UdhavMalpani/Dabba-Ud/outputs/plots/fig2_prop_and_battery_trades.png

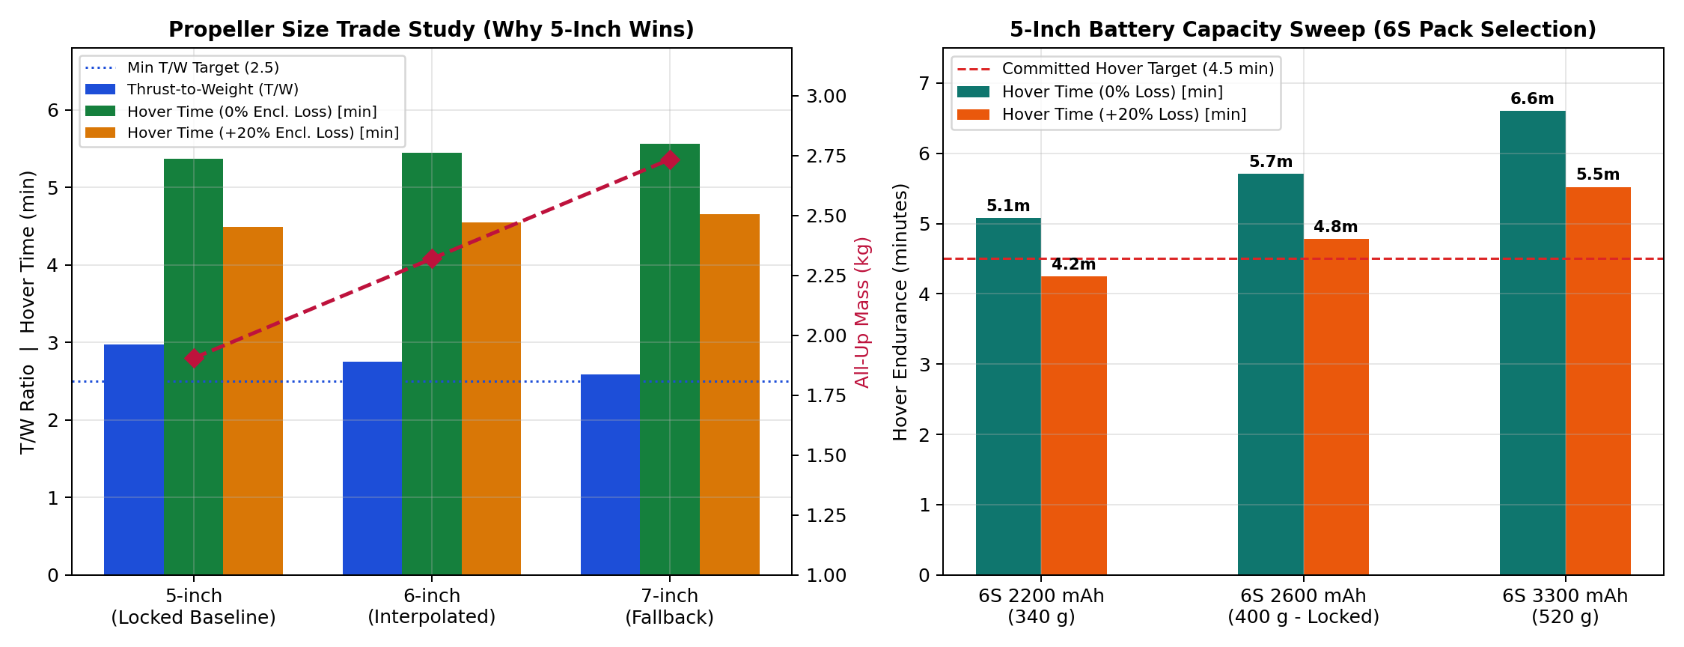
outputs/plots/fig2_prop_and_battery_trades.png
