UdhavMalpani/Dabba-Ud/outputs/plots/fig3_duct_tip_gap_and_stage0_gate.png

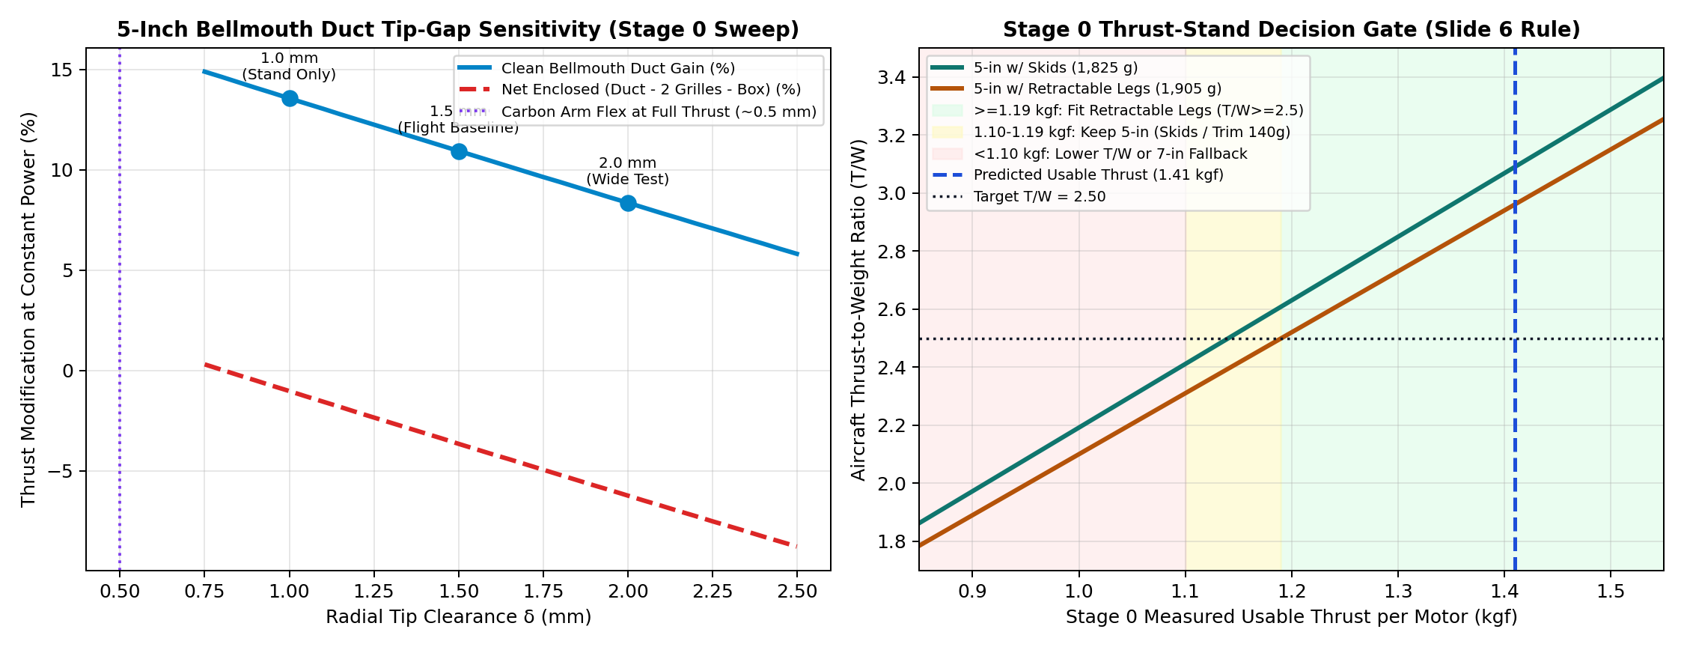
outputs/plots/fig3_duct_tip_gap_and_stage0_gate.png
