UdhavMalpani/Dabba-Ud/outputs/plots/fig4_stage1_vs_stage2_and_payload.png

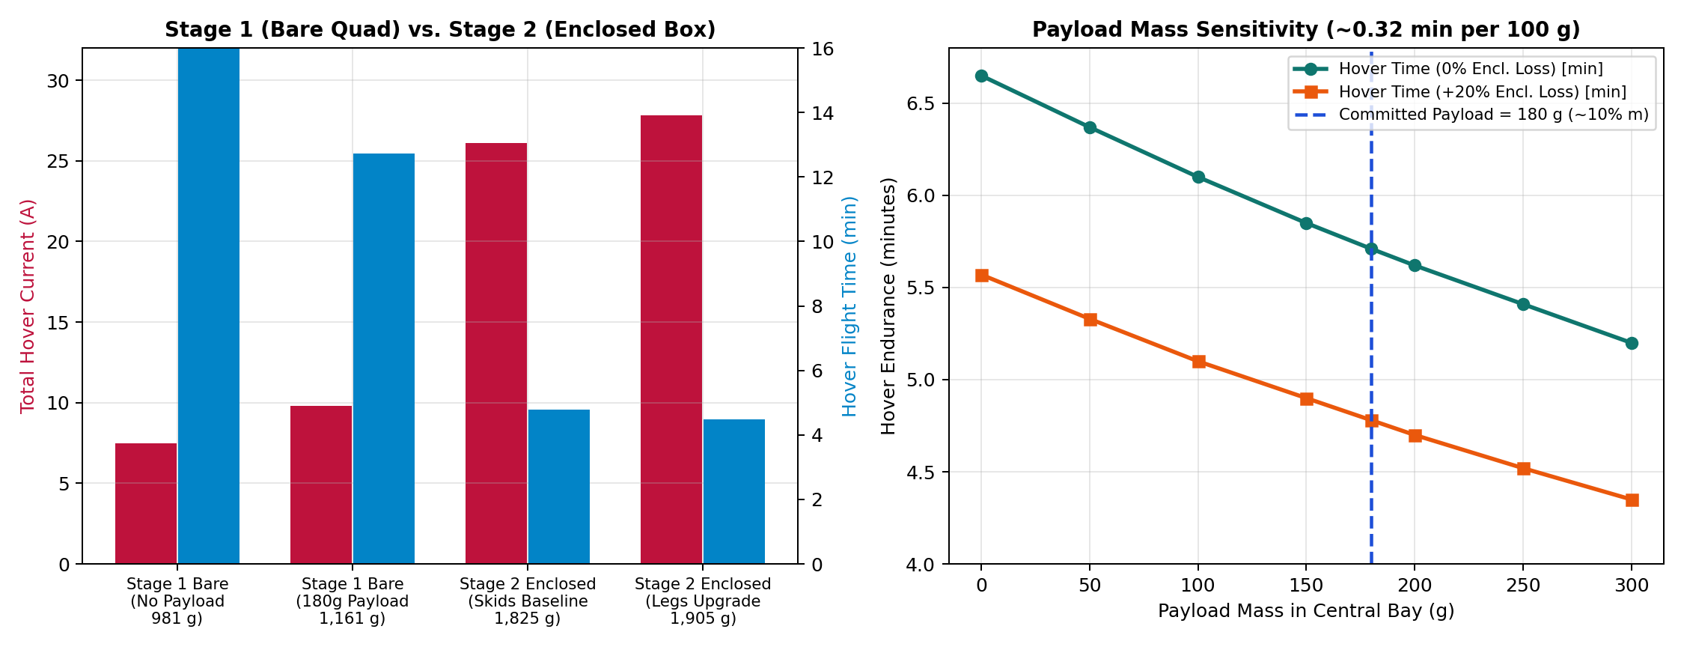
outputs/plots/fig4_stage1_vs_stage2_and_payload.png
