UdhavMalpani/Dabba-Ud/outputs/plots/fig5_crosswind_ram_drag_polar.png

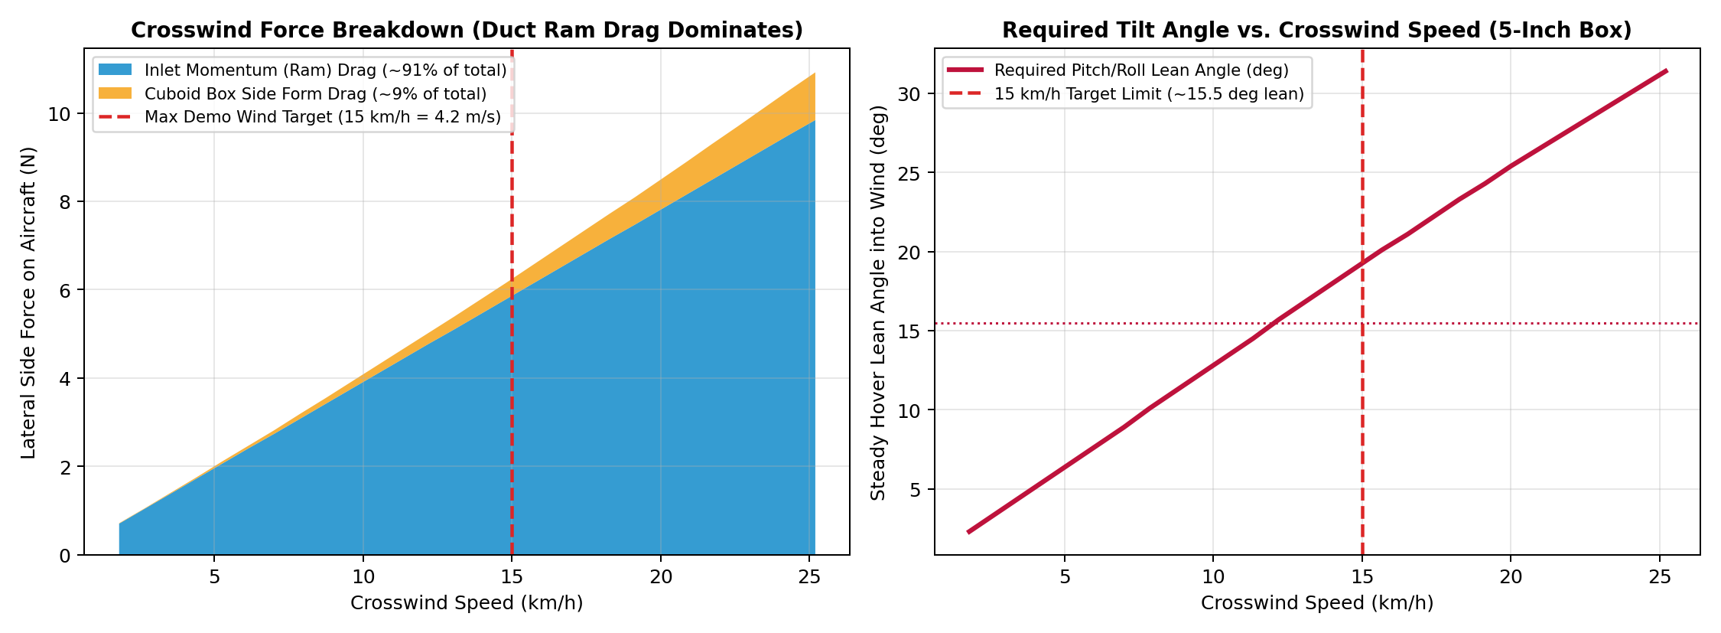
outputs/plots/fig5_crosswind_ram_drag_polar.png
