UdhavMalpani/Dabba-Ud/outputs/plots/fig6_autonomous_mission_and_failsafes.png

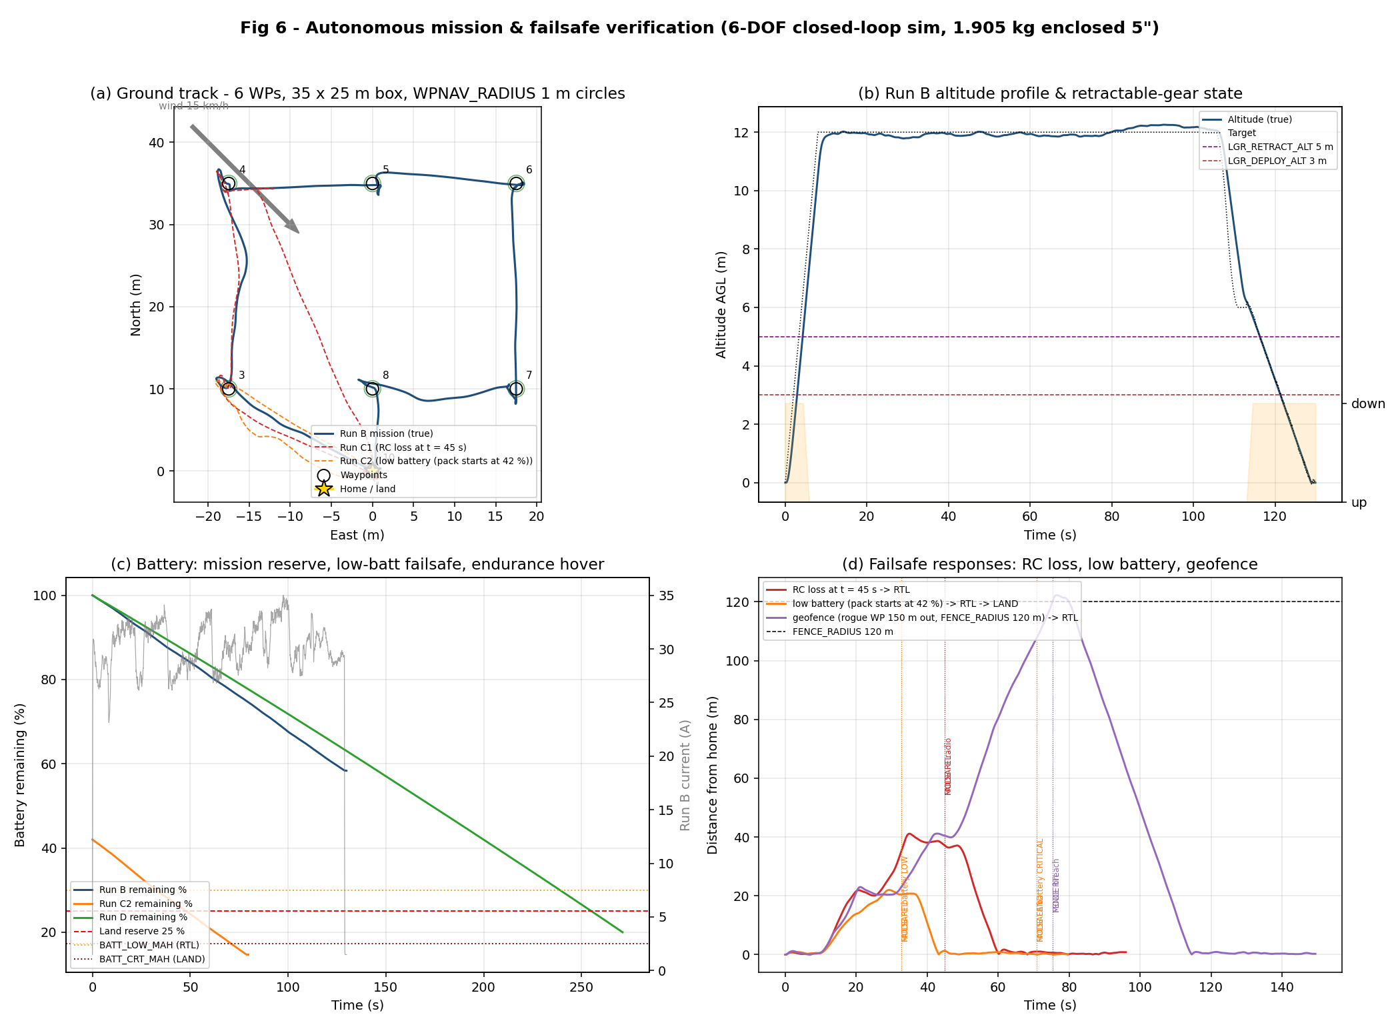
outputs/plots/fig6_autonomous_mission_and_failsafes.png
