UdhavMalpani/Dabba-Ud/outputs/plots/fig9_mass_cg_inertia_audit.png

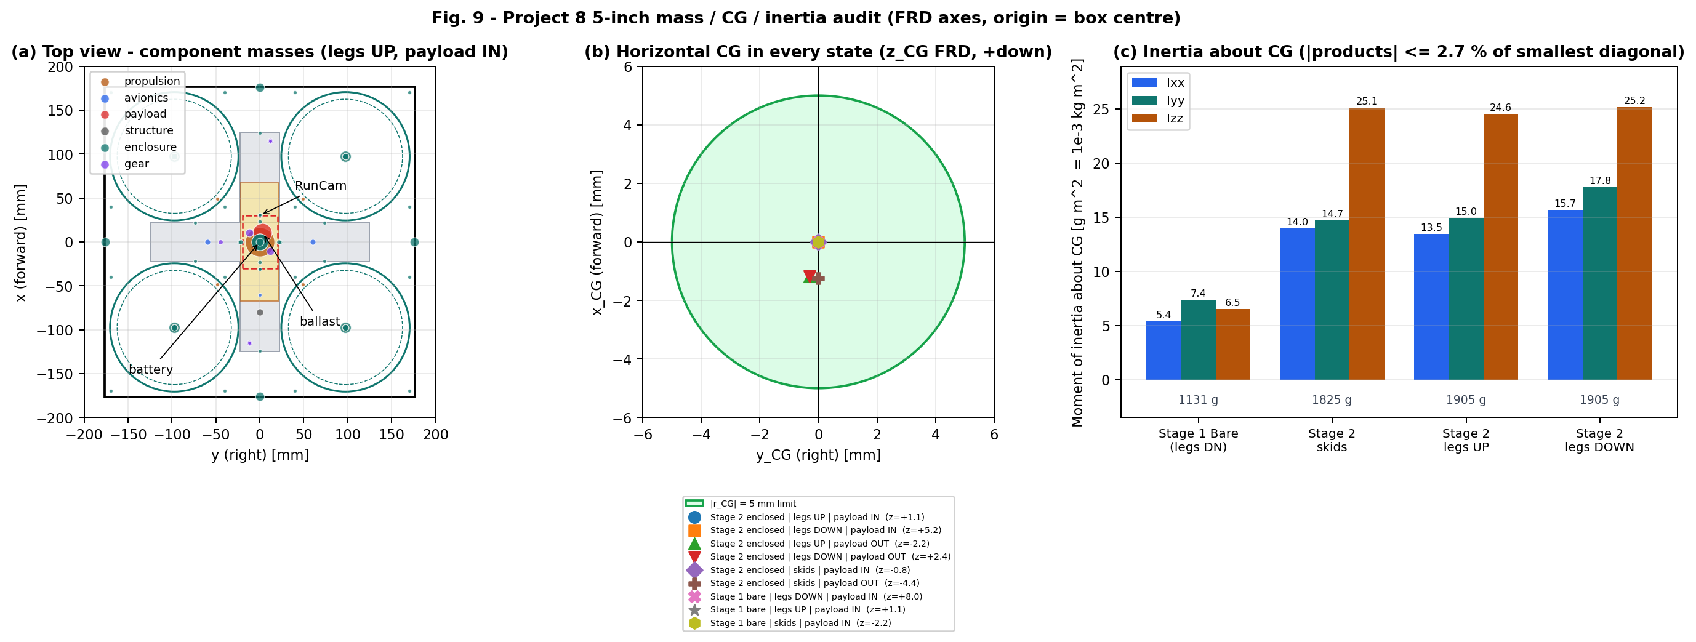
outputs/plots/fig9_mass_cg_inertia_audit.png
