UdhavMalpani/Dabba-Ud/outputs/plots/fig10_single_duct_trial.png

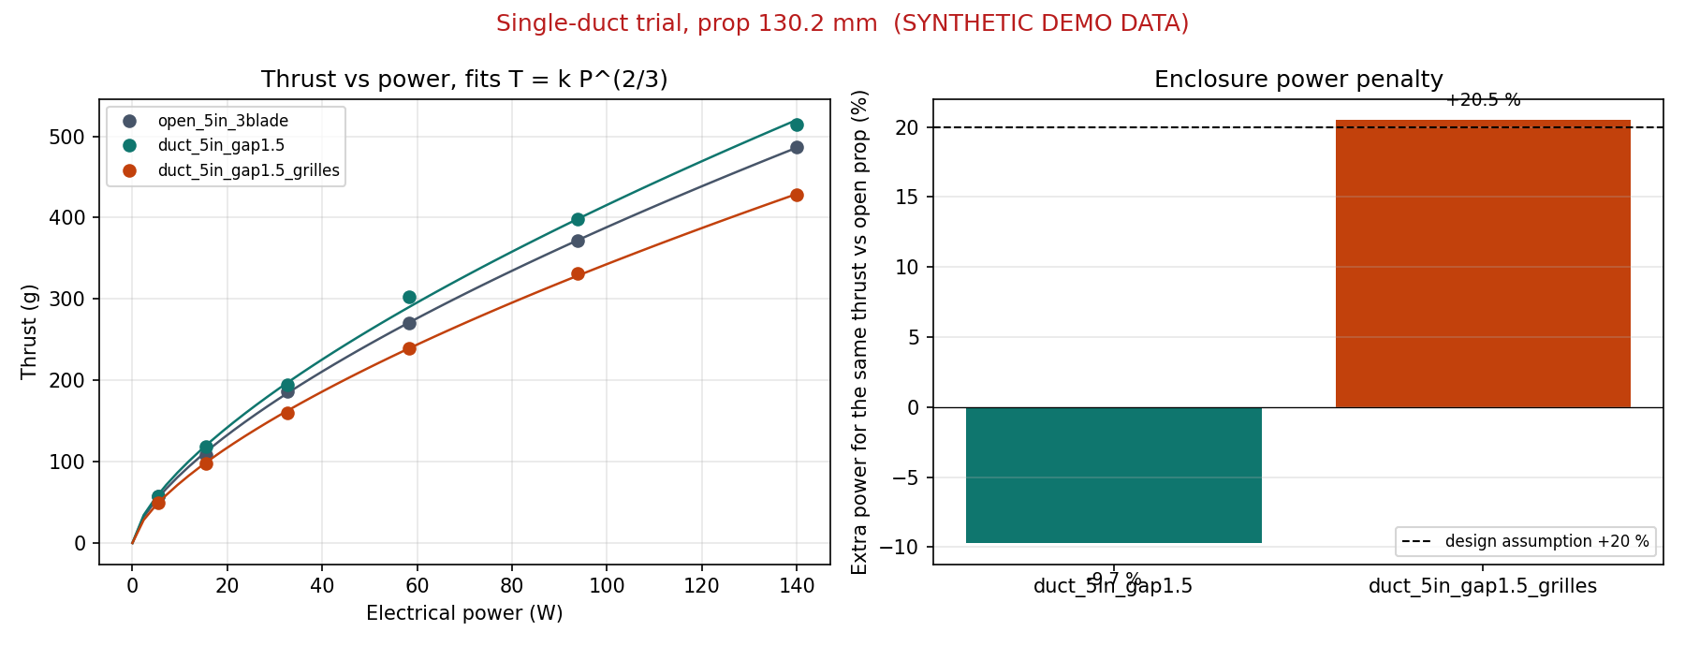
outputs/plots/fig10_single_duct_trial.png
