UdhavMalpani/Dabba-Ud/docs/procurement_robu.xlsx

Sheet: Summary
Project 8 - Robu.in procurement check (5-inch 6S build)
Checked 4 Nov 2026 against 'Project 8 - Component List BOM final.pdf'. Ship to IIIT Hyderabad, PIN 500032.
How to use
- Robu.in blocks automated page loads: stock and prices come from search snapshots, some months old. Open every link and confirm before ordering.
- Yellow cells are inputs: Qty, Unit price, Verified live?, Ordered?. Blue text = entered values. Line and sheet totals are formulas.
- Status colours: green = listing found, amber = substitute or stock uncertain, red = out of stock / not on Robu.
- Qty 0 rows are options (backup props, lab-borrowable telemetry, camera, fallback sets) - set a quantity to include them.
Changes from the submitted BOM
BOM # | BOM item | Problem on Robu | Recommendation
5, 10 | SpeedyBee F405 V4 BLS 60A stack | Out of stock (55A also) | SpeedyBee F405 V3 BLS 50A stack (ArduPilot speedybeef4v3); regenerate param files.
6 | 6S 2600 mAh >=65C XT90 | No 6S 2200-2600 >=65C pack listed | Buy 2600 65C elsewhere (keeps design), or 3 x Bonka 6S 1800 120C - see 'Battery options'.
3 | HQProp 5x4.3x3 | Not listed | Pro-Range 5045 tri-blade (5.0"), keeps 127 mm ducts.
11 | Matek M10Q-5883 | Not listed | Foxeer M10Q 250 GPS 5883.
17 | RunCam Thumb | Out of stock | RunCam Thumb Pro or any <= 30 g 1080p camera; adjust ballast.
31 | PA-CF filament | Not listed | PETG for hinges/mounts, or source elsewhere.
32 | TPU filament | Listed out of stock | Any TPU 95A brand (0.1 kg).
- | Small parts | Not in BOM | Added on 'Small parts' sheet (screws, connectors, leads, smoke stopper...).
Cost roll-up (live from each sheet)
Sheet |  |  | Total (₹)
Flight hardware
Small parts
Build materials
Test equipment
Fallback sets
Grand total (current quantities, excl. shipping)

Sheet: Battery options
6S battery options available on Robu - sizing-model results
Hover time / T/W from src/sizing/sizing_model.py (momentum theory, rho 1.09, FM 0.6, eta 0.8, 80 % usable). Max thrust scaled by (pack continuous current / 160 A)^(2/3) when the pack limits current.
Pack | Mass (g) | Capacity (mAh) | C rating | Max continuous (A) | Max thrust / motor (kgf) | AUW skids (g) | AUW legs (g) | T/W skids | T/W legs | Hover legs 0 % (min) | Hover legs +20 % (min) | Verdict | Inputs
BOM spec: 6S 2600 65C (not on Robu) | 400 | 2600 | 65 |  |  |  |  |  |  | 5.37 | 4.49 | Best - buy elsewhere if allowed. | AUW skids with 400 g pack (g) | 1825.2
Bonka 6S 1800 120C | 313 | 1800 | 120 |  |  |  |  |  |  | 3.98 | 3.33 | Recommended Robu option: full thrust, shorter endurance. | AUW legs with 400 g pack (g) | 1904.9
Pro-Range / Bonka 6S 2500 35C (~390 g est.) | 390 | 2500 | 35 |  |  |  |  |  |  | 5.20 | 4.35 | Fails T/W >= 2.5 (pack current-limited). | Full-throttle current, 4 motors (A) | 160
Orange 6S 3300 35C (~520 g est.) | 520 | 3300 | 35 |  |  |  |  |  |  | 6.22 | 5.20 | Fails T/W target; heavy. | Usable thrust per motor, unlimited (kgf) | 1.41
2 x Bonka 1800 in parallel | 626 | 3600 | 120 |  |  |  |  |  |  | 6.30 | 5.26 | Works but heavy; needs parallel harness and bay space. | Source: BOM PDF (AUW, peak current) and sizing_model.py (usable thrust).
Hover times are sizing-model outputs (hardcoded, blue); re-run src/sizing/sizing_model.py if a pack changes. T/W cells turn red below the 2.5 target.

Sheet: Flight hardware
Flight hardware
Prices/stock from search-engine snapshots of robu.in (some months old) - confirm on the live page. Yellow cells (Qty, Unit price, Verified, Ordered) are editable; line totals recalc.
BOM # | Item | Robu product / pick | Link | Status (search snapshot) | Qty | Unit price (₹) | Line total (₹) | Notes | Verified live? | Ordered?
Propulsion and power
1 | Motors | Emax ECO II 2207 1700 KV | Open (https://robu.in/product/eco-ii-series-2207-1700kv-brushless-motor/) | In stock | 5 | ₹1949 |  | 4 + 1 spare. 33.4 g without leads. Bare leads - solder straight to the 4-in-1 ESC (no bullets needed). Comes with M5 prop nut + screws. Buy ECO II, not ECO III (same price, lower thrust).
3 | Props, 5" tri-blade | Pro-Range 5045 tri-blade bullnose (5.0") | Open (https://robu.in/product/orange-hd-propellers-50455x4-5-blade-bullnose-2cw2ccw-2pairs-orange/) | Substitute | 4 | ₹200 |  | Replaces HQProp 5x4.3x3 (not on Robu). Keeps the 127 mm ducts. Caliper-measure before printing ducts. Price approx.
3b | Props, backup | Pro-Range 51433 Hurricane PC 3-blade (5.1") | Open (https://robu.in/product/orange-hd-51433-hurricane-pc-3-blade-orange/) | Listed | 0 | ₹223 |  | Only if 5045 unavailable: 5.1" needs regenerated ducts (spine clearance drops to ~1.3 mm).
4 | Props, 2-blade (stand only) | Pro-Range 5045 two-blade |  | Check stock | 2 |  |  | Optional - thrust-stand comparison only.
5+10 | FC + ESC stack | SpeedyBee F405 V3 BLS 50A 30x30 stack | Open (https://robu.in/product/speedybee-sb-f4v3-50-stack/) | Substitute | 2 | ₹6500 |  | 1 + 1 spare. Replaces F405 V4 60A (out of stock). 50 A/motor vs ~40 A peak (1.25x). ArduPilot target speedybeef4v3; param files must be regenerated. Includes 1500 uF cap. If V4 60A returns, prefer it.
5 alt | FC + ESC stack (preferred if back) | SpeedyBee F405 V4 BLS 60A stack | Open (https://robu.in/product/speedybee-f405-v4-bls-60a-30x30-fcesc-stack/) | Out of stock | 0 | ₹6979 |  | Original BOM choice.
6 | Battery 6S | Bonka 6S 1800 mAh 120C (313 g) | Open (https://robu.in/product/bonka-1800mah-120c-6s-fpv-u2-series-lithium-polymer-battery-pack/) | Check stock | 3 | ₹5989 |  | Robu has no 6S 2200-2600 >=65C pack. See 'Battery options' sheet. Check size vs 45 mm spine; likely XT60 - re-terminate to XT90 or accept XT60.
7 | Capacitor 1000 uF 50 V | Nichicon UVR1H102MHD | Open (https://robu.in/product/uvr1h102mhd-nichicon-aluminum-electrolytic-capacitor-1000uf/) | Listed | 2 | ₹44 |  | Spare - the stack ships with one.
8 | XT90 female pigtail 12 AWG | SafeConnect XT90 female pigtail | Open (https://robu.in/product/xt90-plug-female-10awg-10cm-1pcsbag/) | Listed | 2 | ₹120 |  | ESC power lead. Check gauge on the page (listing mixes 10/12 AWG).
9 | 12 AWG silicone wire | 1 m red + 1 m black | Open (https://robu.in/product/high-quality-12awg-silicone-wire-1m-red-1m-black/) | Check stock | 1 | ₹228
Avionics and radios
11 | GPS + compass | Foxeer M10Q 250 GPS 5883 | Open (https://robu.in/product/foxeer-m10q-250-gps-5883-compass/) | Substitute | 1 | ₹2729 |  | Replaces Matek M10Q-5883 (not on Robu). Same u-blox M10. Top deck, away from power leads.
13/15 | Telemetry 433 MHz (if lab has none) | Holybro SiK V3 100 mW 433 MHz | Open (https://robu.in/product/holybro-sik-telemetry-radio-v3-100-mw-433-mhz/) | Listed | 0 | ₹6499 |  | Qty 0 = borrow from lab. 433 MHz only (915 MHz not permitted in India).
16 | Buzzer | 5 V active electromagnetic buzzer (pack of 5) | Open (https://robu.in/product/5v-active-electromagnetic-buzzer-pack-of-5/) | Listed | 1 | ₹100 |  | FC BZ+/BZ- pads. Price approx.
Payload
17 | Camera | RunCam Thumb Pro | Open (https://robu.in/product/runcam-thumb-pro-nd-zz/) | Substitute | 0 | ₹10682 |  | RunCam Thumb is out of stock. Qty 0 = decide later; payload stays 180 g (adjust ballast).
Structure
19 | Carbon plate (frame) | Carbon fibre sheet 4 mm, 300 x 300 mm | Open (https://robu.in/product/carbon-fiber-sheet-300300mm-thickness-4-mm/) | In stock | 1 | ₹4693 |  | Cut the 276 mm true-X in the lab - cut wet, wear a mask (carbon dust).
Retractable legs (optional)
A1 | Leg servos | MG90S 9g metal gear, 180 deg | Open (https://robu.in/product/mg90s-9g-servo-metal-gear/) | Listed | 3 | ₹269 |  | 2 + 1 spare. NOT the 360 deg continuous version.
A2 | Servo UBEC | Bluesky mini UBEC 5 V 3 A, 2-6S | Open (https://robu.in/product/bluesky-mini-5v-3a-fpv-gimbal-ptz-ubec-for-rc-air-models/) | Listed | 1 | ₹279 |  | Alt: ReadytoSky switchable 5/12 V - set to 5 V first.
 |  |  |  |  |  | Sheet total |  | Blank unit price = not priced yet (counted as 0).

Sheet: Small parts
Small parts the BOM did not list
Prices/stock from search-engine snapshots of robu.in (some months old) - confirm on the live page. Yellow cells (Qty, Unit price, Verified, Ordered) are editable; line totals recalc.
BOM # | Item | Robu product / pick | Link | Status (search snapshot) | Qty | Unit price (₹) | Line total (₹) | Notes | Verified live? | Ordered?
+ | M3x8 socket screws | EasyMech M3x8 SHCS set (12) | Open (https://robu.in/product/easymech-set-m3-x-8mm-socket-head-cap-allen-bolt-nut-12-pcs/) | Listed | 2 | ₹60 |  | Motor to 4 mm carbon arm - max 4 mm into the motor. Price approx.
+ | M3x6 bolt set | EasyMech M3x6 bolt+nut set (25) | Open (https://robu.in/product/easymech-m3-x-6mm-chhd-bolt-nut-and-washer-set-25-pcs/) | Listed | 1 | ₹60 |  | Price approx.
+ | M3x20 socket screws | EasyMech M3x20 SHCS set (12) | Open (https://robu.in/product/easymech-set-of-m3-x-20mm-socket-head-cap-allen-bolt-and-nut-12-pcs/) | Listed | 1 | ₹80 |  | Price approx.
+ | M3x30 socket screws | EasyMech M3x30 SHCS set (12) | Open (https://robu.in/product/easymech-set-m3-x-30mm-socket-head-cap-allen-bolt-nut-12-pcs/) | Listed | 1 | ₹90 |  | Stack standoffs. Price approx.
+ | M3 nyloc nuts | EasyMech M3 nyloc (25) | Open (https://robu.in/product/easymech-set-m3-ms-nyloc-nut-25pcs/) | Check stock | 1 | ₹78 |  | Frame bolts.
33 | M3 heat-set inserts | M3 x 4 mm brass inserts (25) | Open (https://robu.in/product/m3-x-4-mm-brass-heat-set-knurl-threaded-round-insert-nut-25-pcs/) | Listed | 2 | ₹91 |  | Quarter joints, deck bosses.
+ | XT90 male | Amass XT90 male with housing | Open (https://robu.in/product/xt90-housing-male-1-piece/) | Listed | 3 | ₹71 |  | Spare battery leads / re-termination.
+ | XT90 female | Amass XT90 female with housing | Open (https://robu.in/product/xt90-housing-female-1-piece/) | Listed | 3 | ₹71 |  | Price approx.
+ | XT60 pair | Amass XT60 gold pair | Open (https://robu.in/product/amass-xt60-gold-plated-bullet-battery-connector-pair-xt60-fgy-and-xt60-mgy/) | Listed | 3 | ₹60 |  | Charger, watt meter, thrust stand. Price approx.
+ | 3.5 mm bullet male | Amass GC3510-M | Open (https://robu.in/product/amass-3-5mm-bullet-male-connector-gc3510-m/) | Listed | 6 | ₹20 |  | Thrust stand only (aircraft motors solder direct). Price approx.
+ | 3.5 mm bullet female | Amass GC3510-F | Open (https://robu.in/product/amass-3-5mm-bullet-female-connector-gc3510-f/) | Listed | 6 | ₹20 |  | Price approx.
+ | 18 AWG silicone wire | 18 AWG, 3 colours x 1 m |  | Check stock | 3 |  |  | Motor lead extensions if leads don't reach the stack (~138 mm).
A5 | Servo extension leads 30 cm | Servo extension cable 30 cm |  | Check stock | 3 |  |  | Leg servos to FC.
36 | Battery strap | Non-slip strap 20 x 300 mm | Open (https://robu.in/product/30cm-lipo-battery-strap-belt-reusable-cable-tie-wrap/) | Listed | 2 | ₹61
37 | Heat-shrink assortment | Heat-shrink kit |  | Check stock | 1 |  |  | Every solder joint.
37 | Zip ties, Velcro, 3M foam tape | - |  | Check stock | 1 |  |  | Wiring, receiver mounting.
37 | Threadlocker (medium) | Loctite 243 or equivalent |  | Check stock | 1 |  |  | Motor/frame bolts into metal only, not plastic.
+ | Spare M5 prop nuts | M5 nylock prop nuts CW + CCW |  | Check stock | 8 |  |  | 4 + 4.
+ | Solder + flux | 60/40 solder wire + flux paste |  | Check stock | 1 |  |  | XT90 / 12 AWG joints need >= 60 W iron and flux.
+ | Smoke stopper / 5 A fuse | Smoke stopper (XT60) |  | Check stock | 1 |  |  | First power-up of every build.
+ | Kapton tape | Kapton tape roll |  | Check stock | 1 |  |  | Insulation under the stack.
 |  |  |  |  |  | Sheet total |  | Blank unit price = not priced yet (counted as 0).

Sheet: Build materials
Build materials and consumables
Prices/stock from search-engine snapshots of robu.in (some months old) - confirm on the live page. Yellow cells (Qty, Unit price, Verified, Ordered) are editable; line totals recalc.
BOM # | Item | Robu product / pick | Link | Status (search snapshot) | Qty | Unit price (₹) | Line total (₹) | Notes | Verified live? | Ordered?
29 | PLA filament | Bambu Lab PLA Basic 1 kg | Open (https://robu.in/product/bambu-lab-pla-basic-1-75mm-3d-printing-filament-4/) | In stock | 2 | ₹1149 |  | Enclosure, panels, grilles, spine, door.
30 | PETG filament | Bambu Lab PETG HF 1 kg | Open (https://robu.in/product/bambu-lab-petg-hf-1-75mm-filament-peanut-brown-2/) | Listed | 1 | ₹1299 |  | Duct rings.
31 | PA-CF filament | Not on Robu |  | Not on Robu | 0 |  |  | Print hinges/mounts in PETG for now, or source elsewhere.
32 | TPU 95A filament | Pro-Range TPU 95A 1 kg | Open (https://robu.in/product/pro-range-tpu-95a-filament-1-75mm-1-kg-spool-gray/) | Out of stock | 1 | ₹1029 |  | Only 0.1 kg needed - any TPU 95A brand.
 |  |  |  |  |  | Sheet total |  | Blank unit price = not priced yet (counted as 0).

Sheet: Test equipment
Support and test equipment
Prices/stock from search-engine snapshots of robu.in (some months old) - confirm on the live page. Yellow cells (Qty, Unit price, Verified, Ordered) are editable; line totals recalc.
BOM # | Item | Robu product / pick | Link | Status (search snapshot) | Qty | Unit price (₹) | Line total (₹) | Notes | Verified live? | Ordered?
38 | Load cell + HX711 | 5 kg load cell + HX711 kit | Open (https://robu.in/product/5-kg-load-cell-with-hx711ad-module-shell-and-4p-dupont-wire-kit/) | Listed | 1 | ₹449 |  | Works with firmware/thrust_stand_logger.
38 | Watt meter | 150 A watt meter / power analyser | Open (https://robu.in/product/150a-high-precision-watt-meter-power-analyzer/) | Listed | 1 | ₹689 |  | Bare leads - solder XT60s on.
39 | 6S charger | SkyRC B6ACneo (AC built in) | Open (https://robu.in/product/skyrc-b6ac-neo-dc-200w-ac-60w-battery-charger/) | Listed | 1 | ₹5769 |  | Alt: ToolkitRC M7 (Rs 4,999) is DC-only and needs a power adapter.
40 | LiPo bag | Fireproof bag 230 x 300 mm | Open (https://robu.in/product/red-lithium-battery-protection-bag/) | Listed | 1 | ₹300 |  | Price approx.
41 | Cell checker | 1-8S checker with buzzer | Open (https://robu.in/product/lipo-battery-voltage-checker-1s-8s-with-buzzer/) | Listed | 1 | ₹191
42 | Prop balancer | Magnetic prop balancer |  | Check stock | 1 |  |  | Check listing.
 |  |  |  |  |  | Sheet total |  | Blank unit price = not priced yet (counted as 0).

Sheet: Fallback sets
Fallback sets - order only if needed
Prices/stock from search-engine snapshots of robu.in (some months old) - confirm on the live page. Yellow cells (Qty, Unit price, Verified, Ordered) are editable; line totals recalc.
BOM # | Item | Robu product / pick | Link | Status (search snapshot) | Qty | Unit price (₹) | Line total (₹) | Notes | Verified live? | Ordered?
7-inch fallback (only if Gate 1 thrust is below target)
F1 | Motors | Emax ECO II 2807 1300 KV | Open (https://robu.in/product/emax-ecoii-2807-1300kv-brushless-motor/) | In stock | 0 | ₹2259 |  | Robu spec table looks copy-pasted (1380 g, 9x6 props) - check Emax datasheet.
F2 | Props 7" tri-blade | Pro-Range 7040 Flash PC 3-blade | Open (https://robu.in/product/orange-hd-7040-flash-pc-3-blade-propellers-2cw2ccw-black/) | Substitute | 0 |  |  | Gemfan 7040-3 not on Robu. 178.4 mm disc.
F3 | Battery 6S 3300 | Orange 6S 3300 mAh 35C | Open (https://robu.in/product/orange-3300mah-6s-35c-22-2-v-lithium-polymer-battery-pack-li-po/) | Substitute | 0 |  |  | No >=60C pack on Robu. 116 A continuous - set MOT_BAT_CURR_MAX ~110 A.
4S alternative (only if 6S packs unavailable)
4S | Motors | Emax ECO II 2207 2400 KV | Open (https://robu.in/product/emax-ecoii-2207-2400kv-brushless-motor/) | In stock | 0 | ₹1611 |  | 3-4S.
4S | Battery 4S 4000 >=60C | Not on Robu |  | Not on Robu | 0 |  |  | Source elsewhere.
 |  |  |  |  |  | Sheet total |  | Blank unit price = not priced yet (counted as 0).
