UdhavMalpani/Dabba-Ud/outputs/plots/fig1_sizing_convergence_and_bom.png

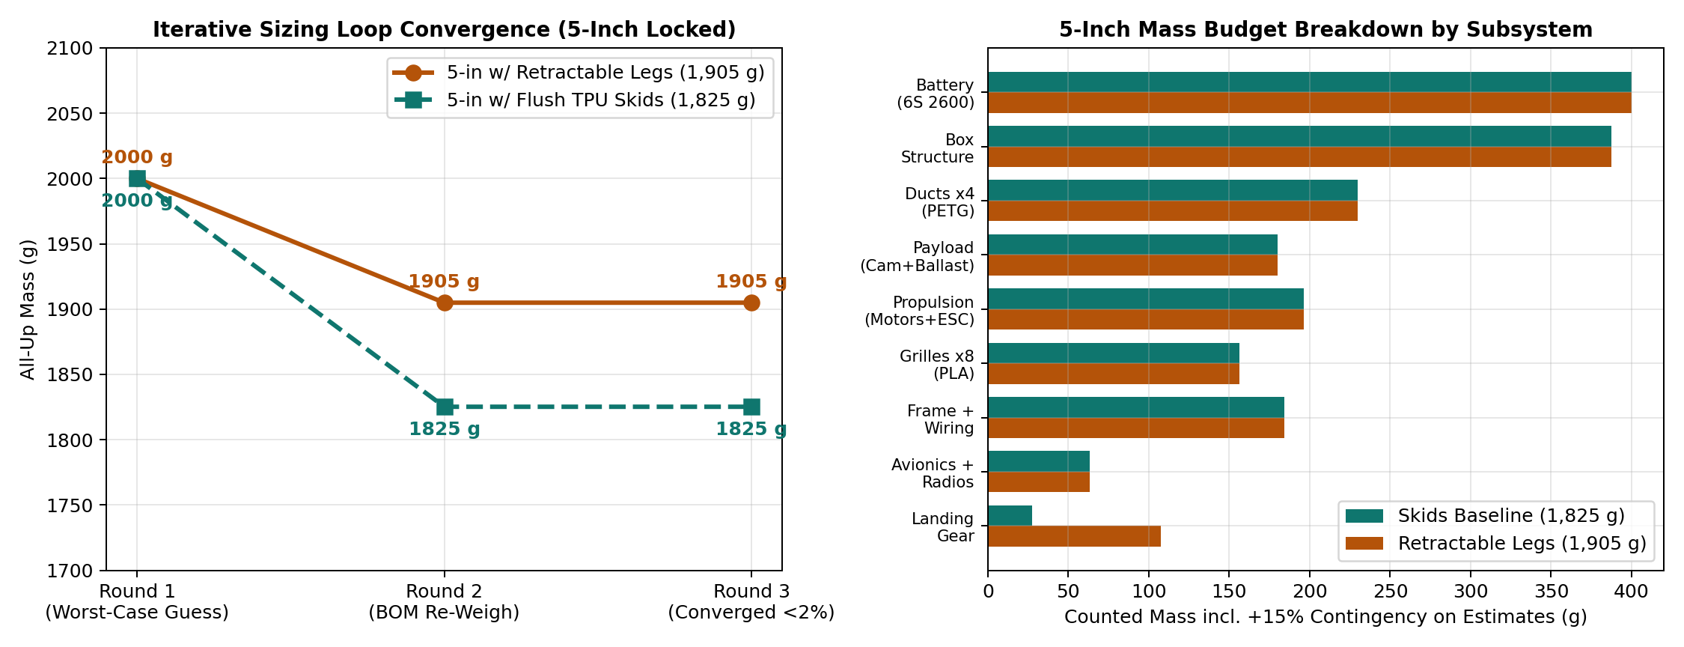
outputs/plots/fig1_sizing_convergence_and_bom.png
