UdhavMalpani/Dabba-Ud/outputs/stl/enclosure_quarter_5in_177mm.stl

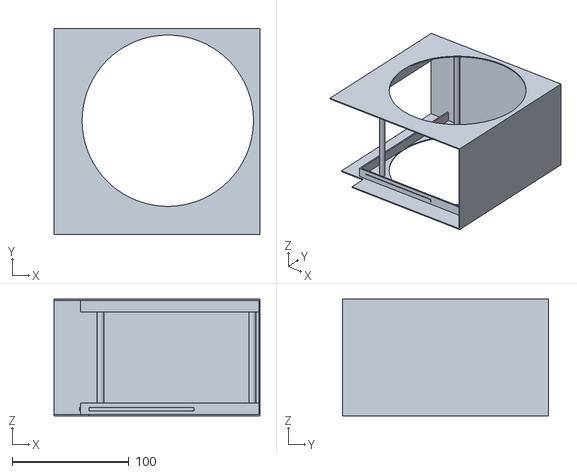
[picture p9: CAD file, 2026-10-30]
outputs/stl/enclosure_quarter_5in_177mm.stl
176.5 x 176.5 x 100.0
