UdhavMalpani/Dabba-Ud/outputs/test_rig/gcode/motor_arm_PLA.gcode.3mf

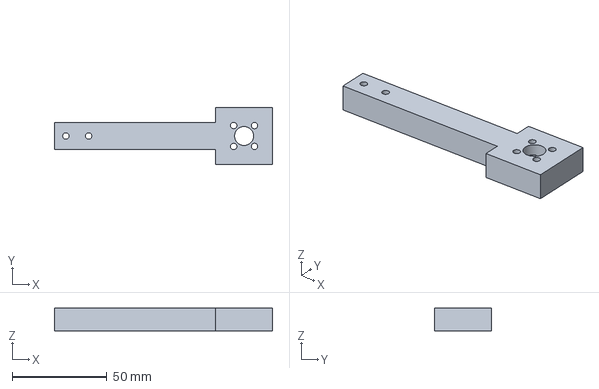
[picture p10: CAD file, 2026-11-03]
outputs/test_rig/gcode/motor_arm_PLA.gcode.3mf
115.0 x 30.0 x 12.0 mm
