UdhavMalpani/Dabba-Ud/outputs/stl/duct_ring_5in_gap1.5mm.stl

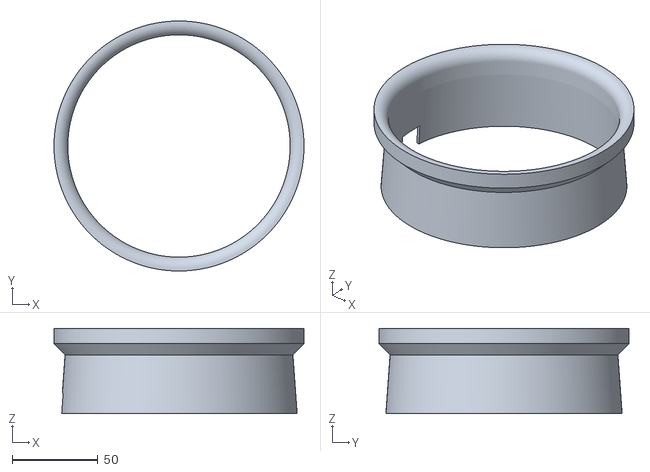
[picture p11: CAD file, 2026-10-30]
outputs/stl/duct_ring_5in_gap1.5mm.stl
146.2 x 146.2 x 50.0
