UdhavMalpani/Dabba-Ud/outputs/test_rig/stand.stl

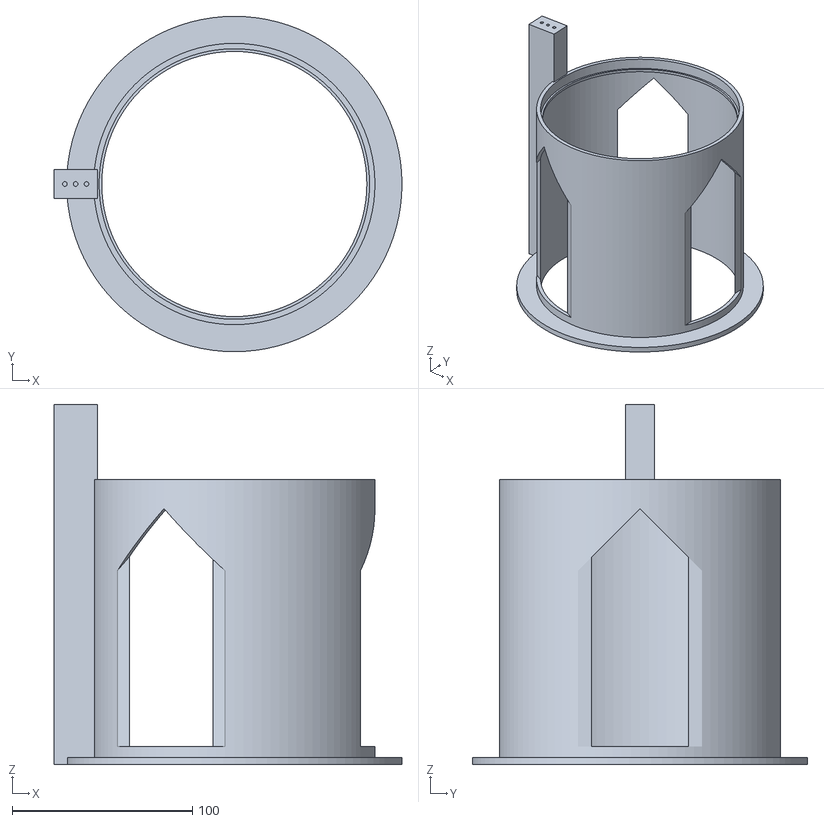
[picture p12: CAD file, 2026-11-03]
outputs/test_rig/stand.stl
193.0 x 186.0 x 199.8
