UdhavMalpani/Dabba-Ud/outputs/stl/retractable_leg_240mm.stl

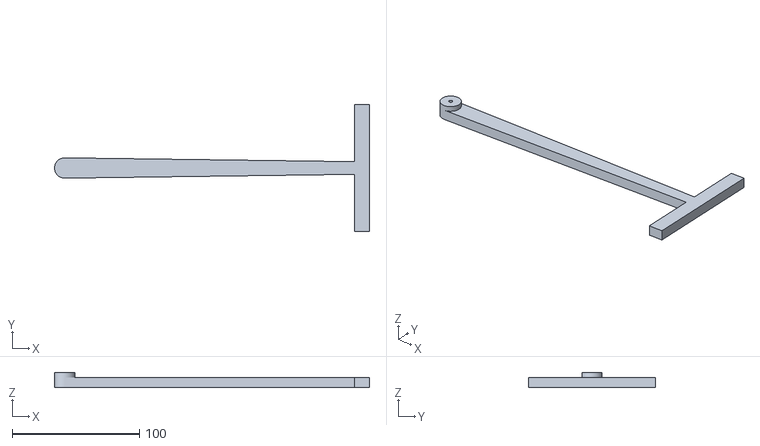
[picture p13: CAD file, 2026-10-30]
outputs/stl/retractable_leg_240mm.stl
248.0 x 100.0 x 12.0
