UdhavMalpani/Dabba-Ud/outputs/test_rig/gcode/duct_test_rig.gcode.3mf

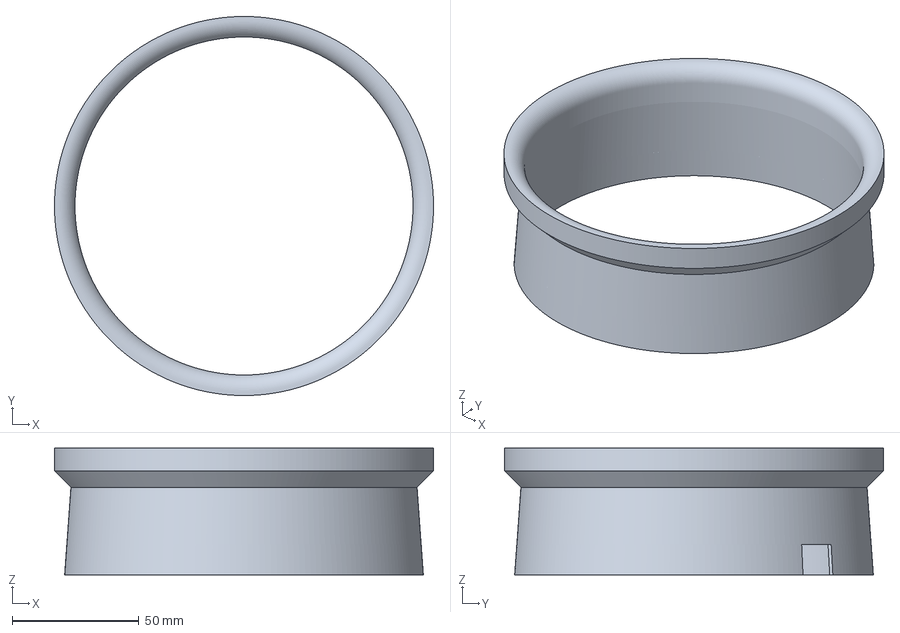
[picture p14: CAD file, 2026-11-03]
outputs/test_rig/gcode/duct_test_rig.gcode.3mf
149.4 x 149.4 x 50.0 mm
