UdhavMalpani/Dabba-Ud/outputs/test_rig/open_riser.stl

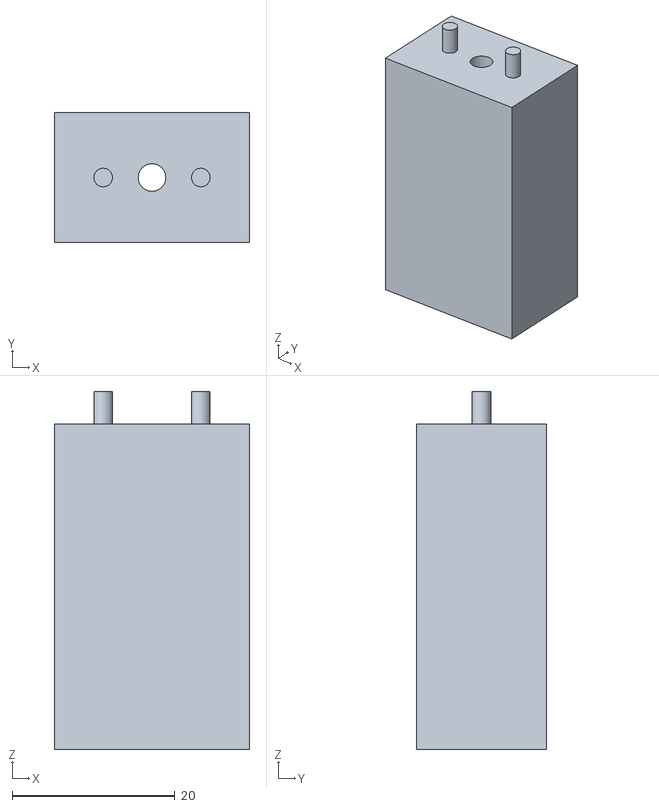
[picture p15: CAD file, 2026-11-03]
outputs/test_rig/open_riser.stl
24.0 x 16.0 x 44.0
