UdhavMalpani/Dabba-Ud/outputs/stl/grille_5in_146mm_4mm.stl

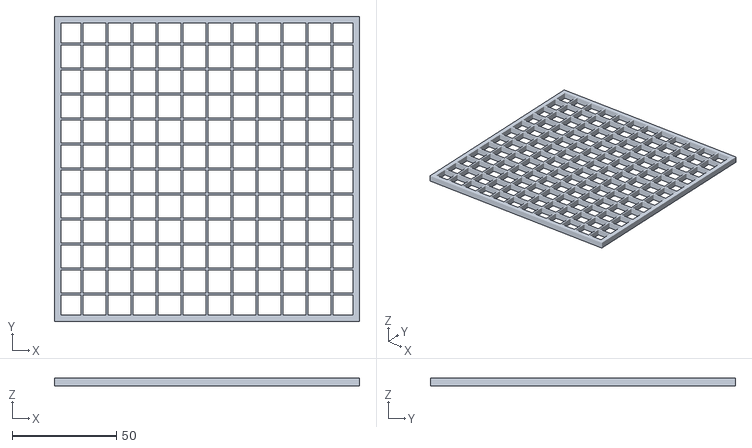
[picture p16: CAD file, 2026-10-30]
outputs/stl/grille_5in_146mm_4mm.stl
146.2 x 146.2 x 4.00
