UdhavMalpani/Dabba-Ud/outputs/test_rig/inlet_grille.stl

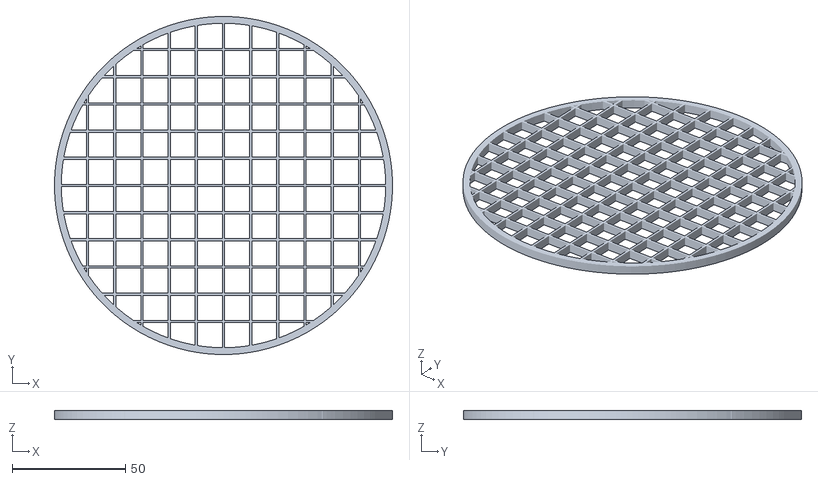
[picture p17: CAD file, 2026-11-03]
outputs/test_rig/inlet_grille.stl
149.2 x 149.2 x 4.00
