UdhavMalpani/Dabba-Ud/outputs/stl/duct_ring_5in_gap1.0mm.stl

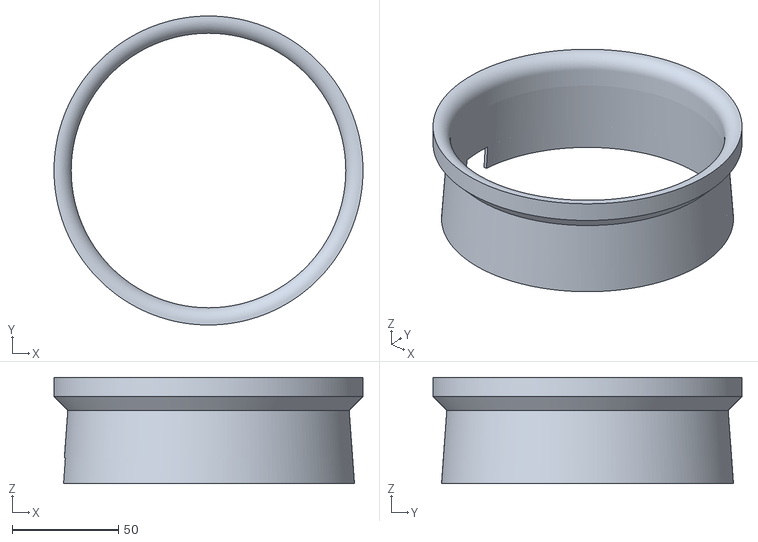
[picture p18: CAD file, 2026-10-30]
outputs/stl/duct_ring_5in_gap1.0mm.stl
145.2 x 145.2 x 50.0
