UdhavMalpani/Dabba-Ud/outputs/test_rig/fit_band.stl

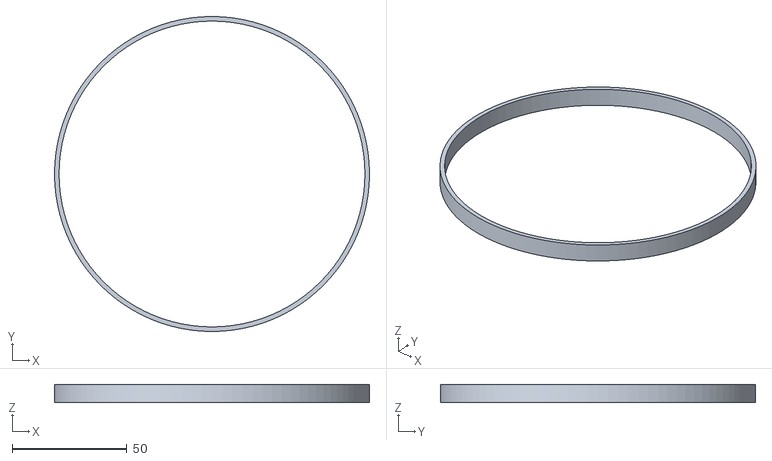
[picture p19: CAD file, 2026-11-03]
outputs/test_rig/fit_band.stl
137.2 x 137.2 x 8.00
