UdhavMalpani/Dabba-Ud/outputs/stl/cross_spine_45mm_payload_bay.stl

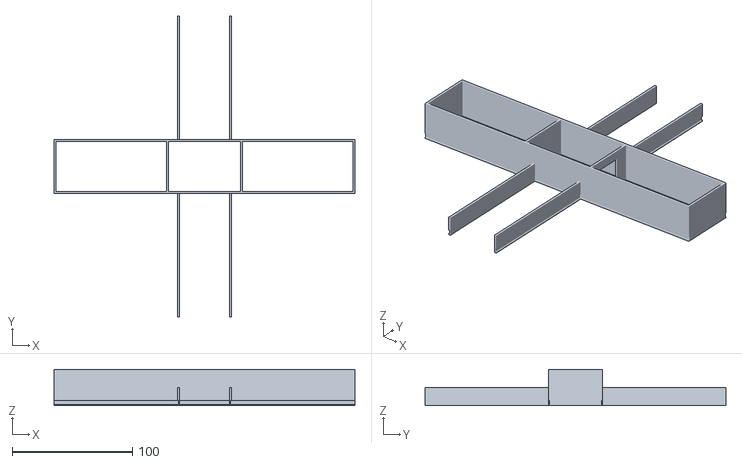
[picture p20: CAD file, 2026-10-30]
outputs/stl/cross_spine_45mm_payload_bay.stl
250.0 x 250.0 x 30.0
