UdhavMalpani/Dabba-Ud/outputs/test_rig/test_rig_dims.scad

// generated by src/cad/generate_test_rig.py from config/test_rig_measurements.json - do not edit
prop_d = 130.200;
tip_gap = 1.500;
motor_bolt_min = 11.000;
motor_bolt_max = 11.000;
motor_seat_h = 34.000;
prop_hub_t = 7.500;
motor_bell_d = 27.500;
motor_center_d = 10.000;
inlet_clear = 150.000;
