UdhavMalpani/Dabba-Ud/(list of files, cad)

Other CAD files:
outputs/test_rig/motor_arm.stl
outputs/test_rig/gcode/motor_arm.gcode.3mf
outputs/test_rig/gcode/open_riser.gcode.3mf
outputs/test_rig/gcode/stand.gcode.3mf
outputs/stl/duct_ring_5in_gap2.0mm.stl
outputs/test_rig/gcode/fit_band_PLA.gcode.3mf
outputs/test_rig/grille_test_rig.stl
outputs/test_rig/duct_test_rig.stl
outputs/test_rig/gcode/duct_test_rig_PLA.gcode.3mf
outputs/test_rig/gcode/inlet_grille.gcode.3mf
outputs/test_rig/gcode/grille_test_rig.gcode.3mf
outputs/test_rig/gcode/fit_band.gcode.3mf
