UdhavMalpani/Dabba-Ud/outputs/test_rig/assembly_cutaway.png

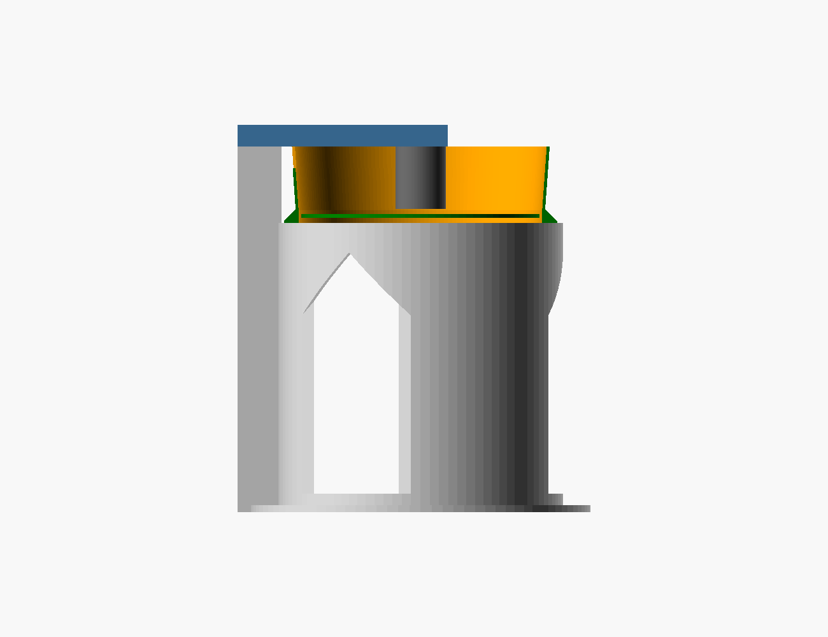
outputs/test_rig/assembly_cutaway.png
