UdhavMalpani/Dabba-Ud/outputs/test_rig/assembly_preview.png

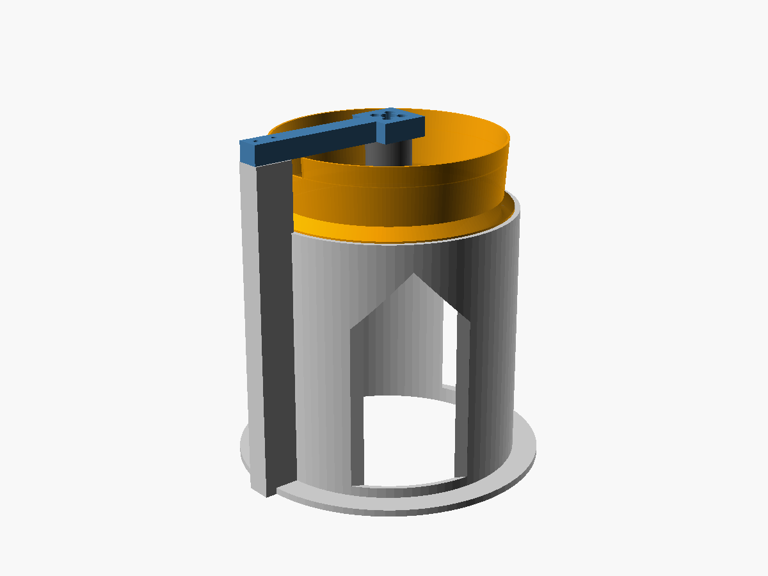
outputs/test_rig/assembly_preview.png
