UdhavMalpani/Dabba-Ud/outputs/test_rig/single_duct_trial_DEMO_synthetic.csv

# SYNTHETIC demo data - generated by --demo | not a measurement
config | tip_gap_mm | pwm_us | throttle_pct | thrust_g | voltage_v | current_a | power_w | rpm
open_5in_3blade |  | 1200 | 20 | 57 | 15.59 | 0.35 | 5.4 | 0
open_5in_3blade |  | 1300 | 30 | 108 | 15.58 | 0.99 | 15.5 | 0
open_5in_3blade |  | 1400 | 40 | 186 | 15.56 | 2.10 | 32.7 | 0
open_5in_3blade |  | 1500 | 50 | 270 | 15.53 | 3.76 | 58.4 | 0
open_5in_3blade |  | 1600 | 60 | 372 | 15.48 | 6.06 | 93.8 | 0
open_5in_3blade |  | 1700 | 70 | 487 | 15.42 | 9.08 | 140.0 | 0
duct_5in_gap1.5 | 1.5 | 1200 | 20 | 57 | 15.59 | 0.35 | 5.4 | 0
duct_5in_gap1.5 | 1.5 | 1300 | 30 | 119 | 15.58 | 0.99 | 15.5 | 0
duct_5in_gap1.5 | 1.5 | 1400 | 40 | 194 | 15.56 | 2.10 | 32.7 | 0
duct_5in_gap1.5 | 1.5 | 1500 | 50 | 303 | 15.53 | 3.76 | 58.4 | 0
duct_5in_gap1.5 | 1.5 | 1600 | 60 | 398 | 15.48 | 6.06 | 93.8 | 0
duct_5in_gap1.5 | 1.5 | 1700 | 70 | 515 | 15.42 | 9.08 | 140.0 | 0
duct_5in_gap1.5_grilles | 1.5 | 1200 | 20 | 49 | 15.59 | 0.35 | 5.4 | 0
duct_5in_gap1.5_grilles | 1.5 | 1300 | 30 | 98 | 15.58 | 0.99 | 15.5 | 0
duct_5in_gap1.5_grilles | 1.5 | 1400 | 40 | 160 | 15.56 | 2.10 | 32.7 | 0
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
