UdhavMalpani/Dabba-Ud/outputs/plots/fig7_stage0_thrust_stand_results.png

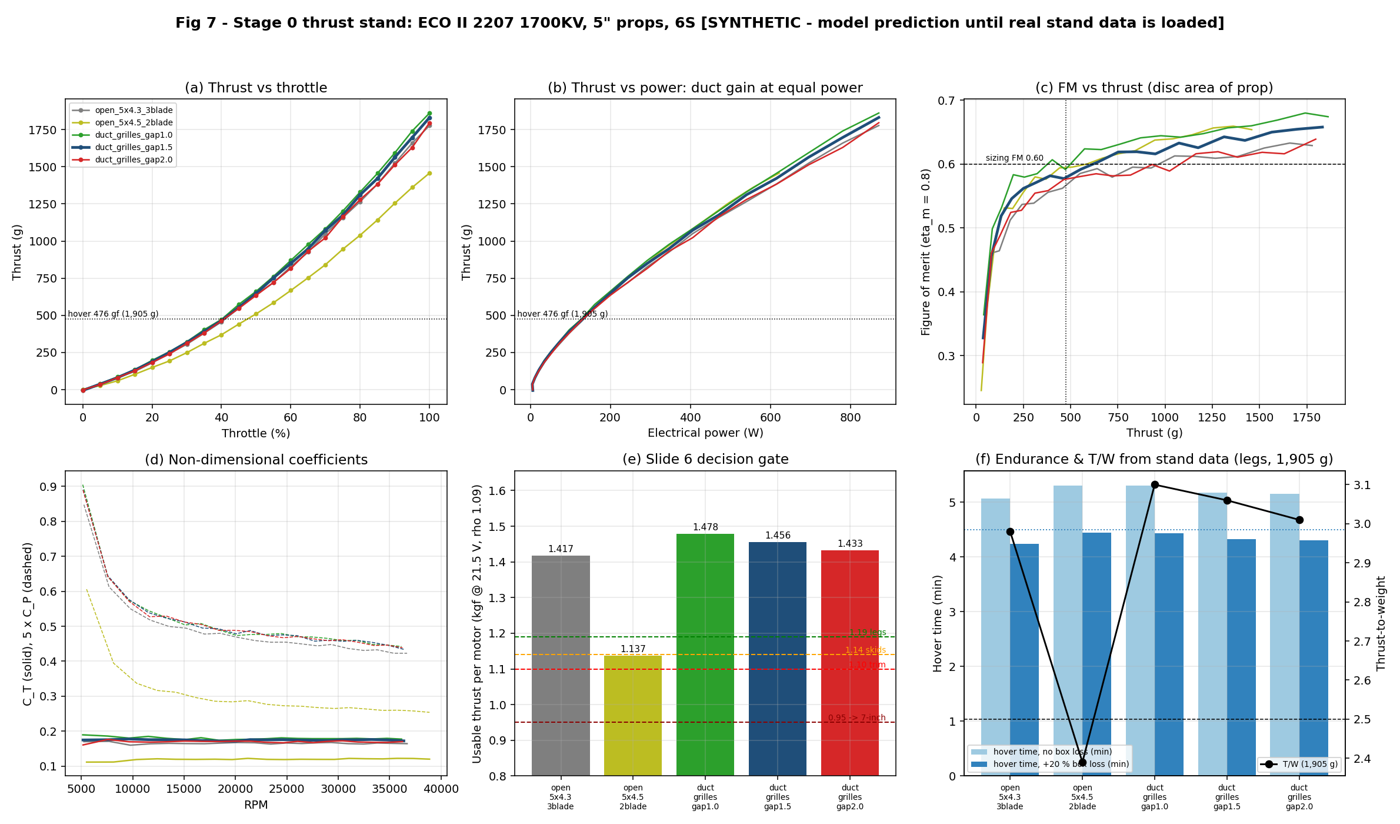
outputs/plots/fig7_stage0_thrust_stand_results.png
