UdhavMalpani/Dabba-Ud/outputs/plots/fig8_flight_log_gate_verification.png

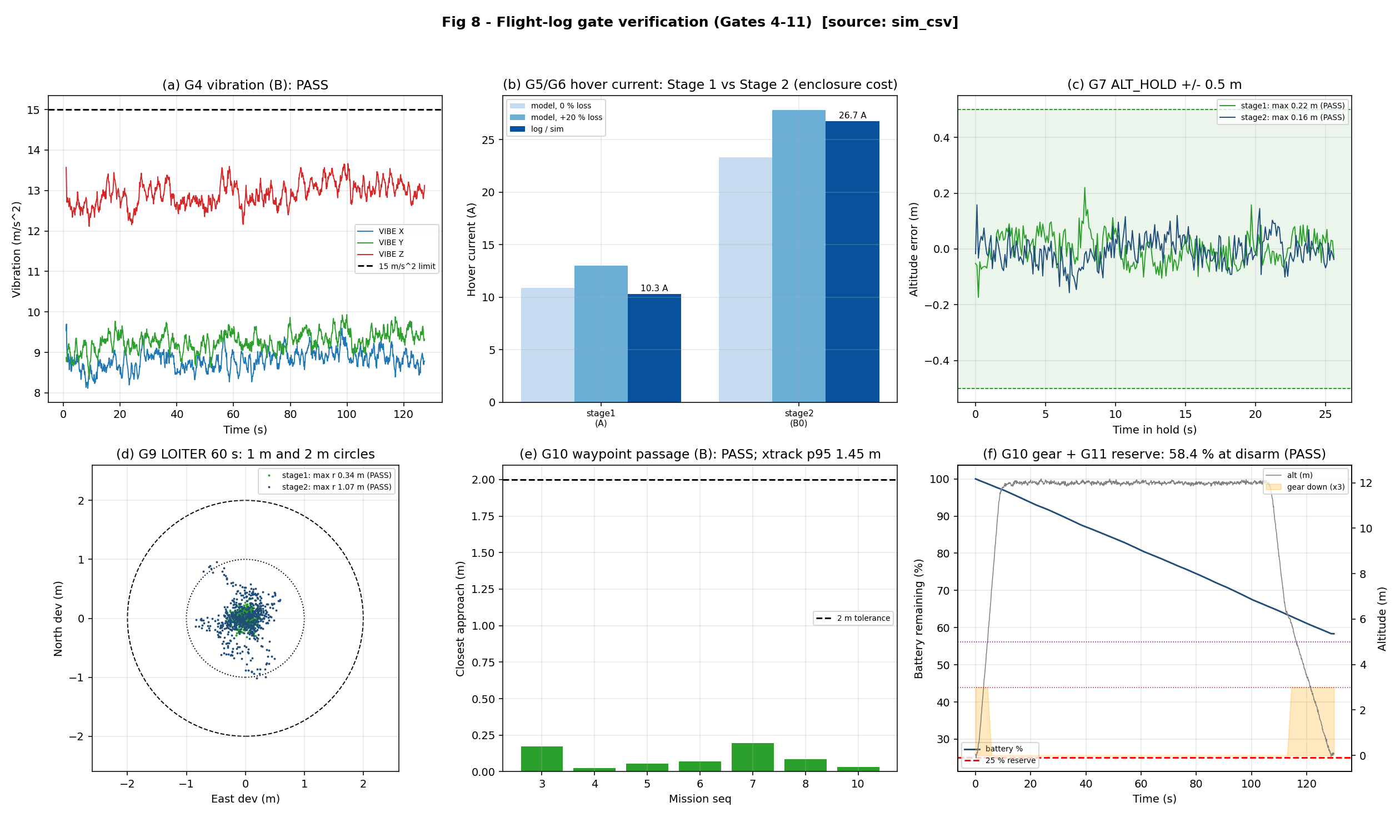
outputs/plots/fig8_flight_log_gate_verification.png
