UdhavMalpani/Dabba-Ud/outputs/test_rig/motor_arm_top.png

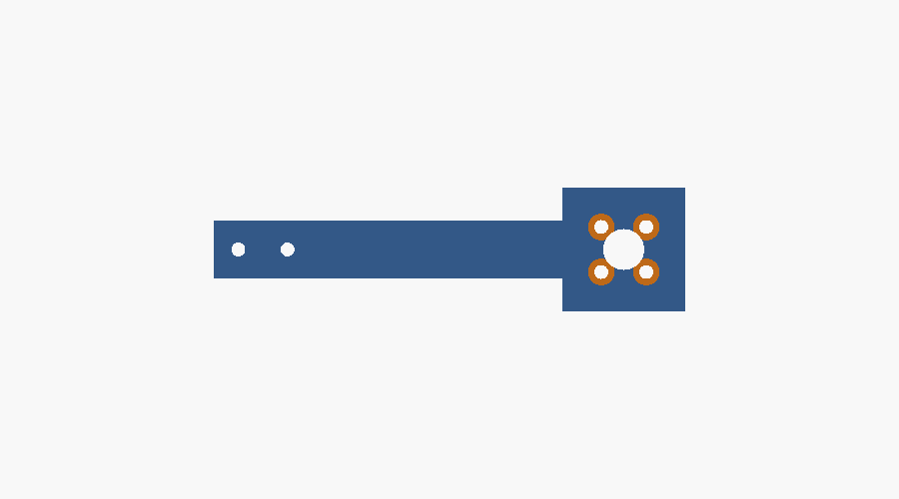
outputs/test_rig/motor_arm_top.png
