UdhavMalpani/Dabba-Ud/config/ardupilot/stage1_bare_5in.param

FRAME_CLASS,1
FRAME_TYPE,1
SERVO1_FUNCTION,36
SERVO2_FUNCTION,33
SERVO3_FUNCTION,34
SERVO4_FUNCTION,35
SERVO5_FUNCTION,0
SERVO6_FUNCTION,0
MOT_PWM_TYPE,6
MOT_SPIN_ARM,0.07
MOT_SPIN_MIN,0.10
MOT_SPIN_MAX,0.95
MOT_THST_EXPO,0.65
MOT_THST_HOVER,0.20
MOT_HOVER_LEARN,2
MOT_BAT_VOLT_MAX,25.2
MOT_BAT_VOLT_MIN,19.8
MOT_BAT_CURR_MAX,160
MOT_BAT_IDX,0
BATT_MONITOR,4
BATT_CAPACITY,2600
BATT_AMP_PERVLT,25.0
BATT_AMP_OFFSET,0.0
BATT_LOW_VOLT,21.0
BATT_CRT_VOLT,19.8
BATT_FS_VOLTSRC,1
BATT_LOW_TIMER,10
BATT_LOW_MAH,780
BATT_CRT_MAH,450
BATT_FS_LOW_ACT,2
BATT_FS_CRT_ACT,1
BATT_ARM_VOLT,23.1
INS_HNTCH_ENABLE,1
INS_HNTCH_MODE,3
INS_HNTCH_REF,1
INS_HNTCH_FREQ,200
INS_HNTCH_BW,100
INS_HNTCH_ATT,40
INS_HNTCH_HMNCS,5
INS_HNTCH_OPTS,0
INS_GYRO_FILTER,80
ATC_RAT_RLL_P,0.085
ATC_RAT_RLL_I,0.085
ATC_RAT_RLL_D,0.0018
ATC_RAT_RLL_FLTD,40
ATC_RAT_RLL_FLTT,40
ATC_RAT_PIT_P,0.085
ATC_RAT_PIT_I,0.085
ATC_RAT_PIT_D,0.0018
ATC_RAT_PIT_FLTD,40
ATC_RAT_PIT_FLTT,40
ATC_RAT_YAW_P,0.18
ATC_RAT_YAW_I,0.018
ATC_RAT_YAW_D,0.0
ATC_RAT_YAW_FLTE,2
ATC_RATE_R_MAX,360
ATC_RATE_P_MAX,360
ATC_RATE_Y_MAX,180
SERIAL2_PROTOCOL,23
FLTMODE_CH,5
FLTMODE1,0
FLTMODE2,2
FLTMODE3,5
FLTMODE4,15
FLTMODE5,6
FLTMODE6,9
SERIAL6_PROTOCOL,5
SERIAL6_BAUD,230
SERIAL1_PROTOCOL,2
SERIAL1_BAUD,57
SERIAL3_PROTOCOL,-1
SERIAL5_PROTOCOL,-1
