UdhavMalpani/Dabba-Ud/(commit log)

2026-10-30 Project 8: enclosed ducted-fan quadrotor design, simulation and verification pipeline
    Sizing, CAD/STL generation, mass/CG/inertia audit, ArduPilot params and SITL configs, 6-DOF mission simulator, thrust-stand and flight-log gate analyzers, technical report, README and next steps.
    [cross_spine_45mm_payload_bay.stl, duct_ring_5in_gap1.0mm.stl, duct_ring_5in_gap1.5mm.stl, duct_ring_5in_gap2.0mm.stl, enclosure_quarter_5in_177mm.stl, fusion360_parameters_5in.csv, grille_5in_146mm_4mm.stl, project8_5in_parametric.scad]
2026-11-03 Add pre-component single-duct thrust rig and trial analyzer
    Kitchen-scale rig for measuring the enclosure power penalty with lab-spare parts while flight components are on order. Prop measured at 130.2 mm (3 x 65.1 mm blades); duct, grilles, fit band, windowed stand, motor arm and open-prop riser generated and checked closed. Trial analyzer fits T = k P^(2/3) per config and reports the power penalty vs the +20 % sizing assumption. Guide includes session notes for carrying context into claude.ai.
    [duct_test_rig.stl, fit_band.stl, grille_test_rig.stl, inlet_grille.stl, motor_arm.stl, open_riser.stl, single_duct_trial_DEMO_synthetic.csv, single_duct_trial_template.csv]
2026-11-03 Add P1S slicing for the test rig (Bambu Studio CLI) and ready-to-print gcode
    slice_test_rig.py flattens the installed Bambu P1S 0.4 / 0.20mm Standard / PLA+PETG Basic presets and slices every rig part with 2 walls, 15 % gyroid, Textured PEI plate. Slicer filament weights agree with the mass model (duct 52 g vs 57 g est., stand 184 g vs 178 g).
    [duct_test_rig.gcode.3mf, fit_band.gcode.3mf, grille_test_rig.gcode.3mf, inlet_grille.gcode.3mf, motor_arm.gcode.3mf, open_riser.gcode.3mf, stand.gcode.3mf]
2026-11-03 Add PLA versions of the PETG test-rig prints (--material override)
    [duct_test_rig_PLA.gcode.3mf, fit_band_PLA.gcode.3mf, motor_arm_PLA.gcode.3mf]
2026-11-03 Rig regenerated for the measured A2217 test motor
    Square 11 mm hole pattern, 34 mm base-to-seat, 7.5 mm hub, 27.5 mm bell, 4 mm shaft. Stand post +4.3 mm, smaller arm pad; stand, arm and riser re-sliced.
    [duct_test_rig.gcode.3mf, fit_band.stl, inlet_grille.stl, motor_arm.gcode.3mf, motor_arm.stl, motor_arm_PLA.gcode.3mf, open_riser.gcode.3mf, open_riser.stl]
2026-11-03 Record APM 2.x flight controller; add rig cut-away and arm top-view renders
2026-11-04 Add Robu.in procurement check for the BOM
    Availability, substitutes (V3 50A stack, Bonka 6S 1800 120C, Pro-Range 5045 tri, Foxeer M10Q), battery trade study from the sizing model, and the small parts the BOM omitted.
2026-11-04 Add procurement workbook (Robu.in order list with live totals)
    [procurement_robu.xlsx]
